andykarpov/skvosh/ERRATA-revA.txt

1. Резисторы R21, R22, R23 не запаивать либо подобрать
2. Вместо диода D8 запаять перемычку 0 Ом
3. Диоды D9, D10, D11 не запаивать
4. Питание для микросхемы К145ИК17 нужно подбирать, ориентировочно - 6В, от 5В работает нестабильно
5. В узле генератора нужно применять микросхему серии ACT, серия HC нестабильна
6. Вывечти на левый разъем пины для пистолета (возможно, вместе со схемой)
