andykarpov/skvosh/docs/skvosh-pcb-revB.pdf

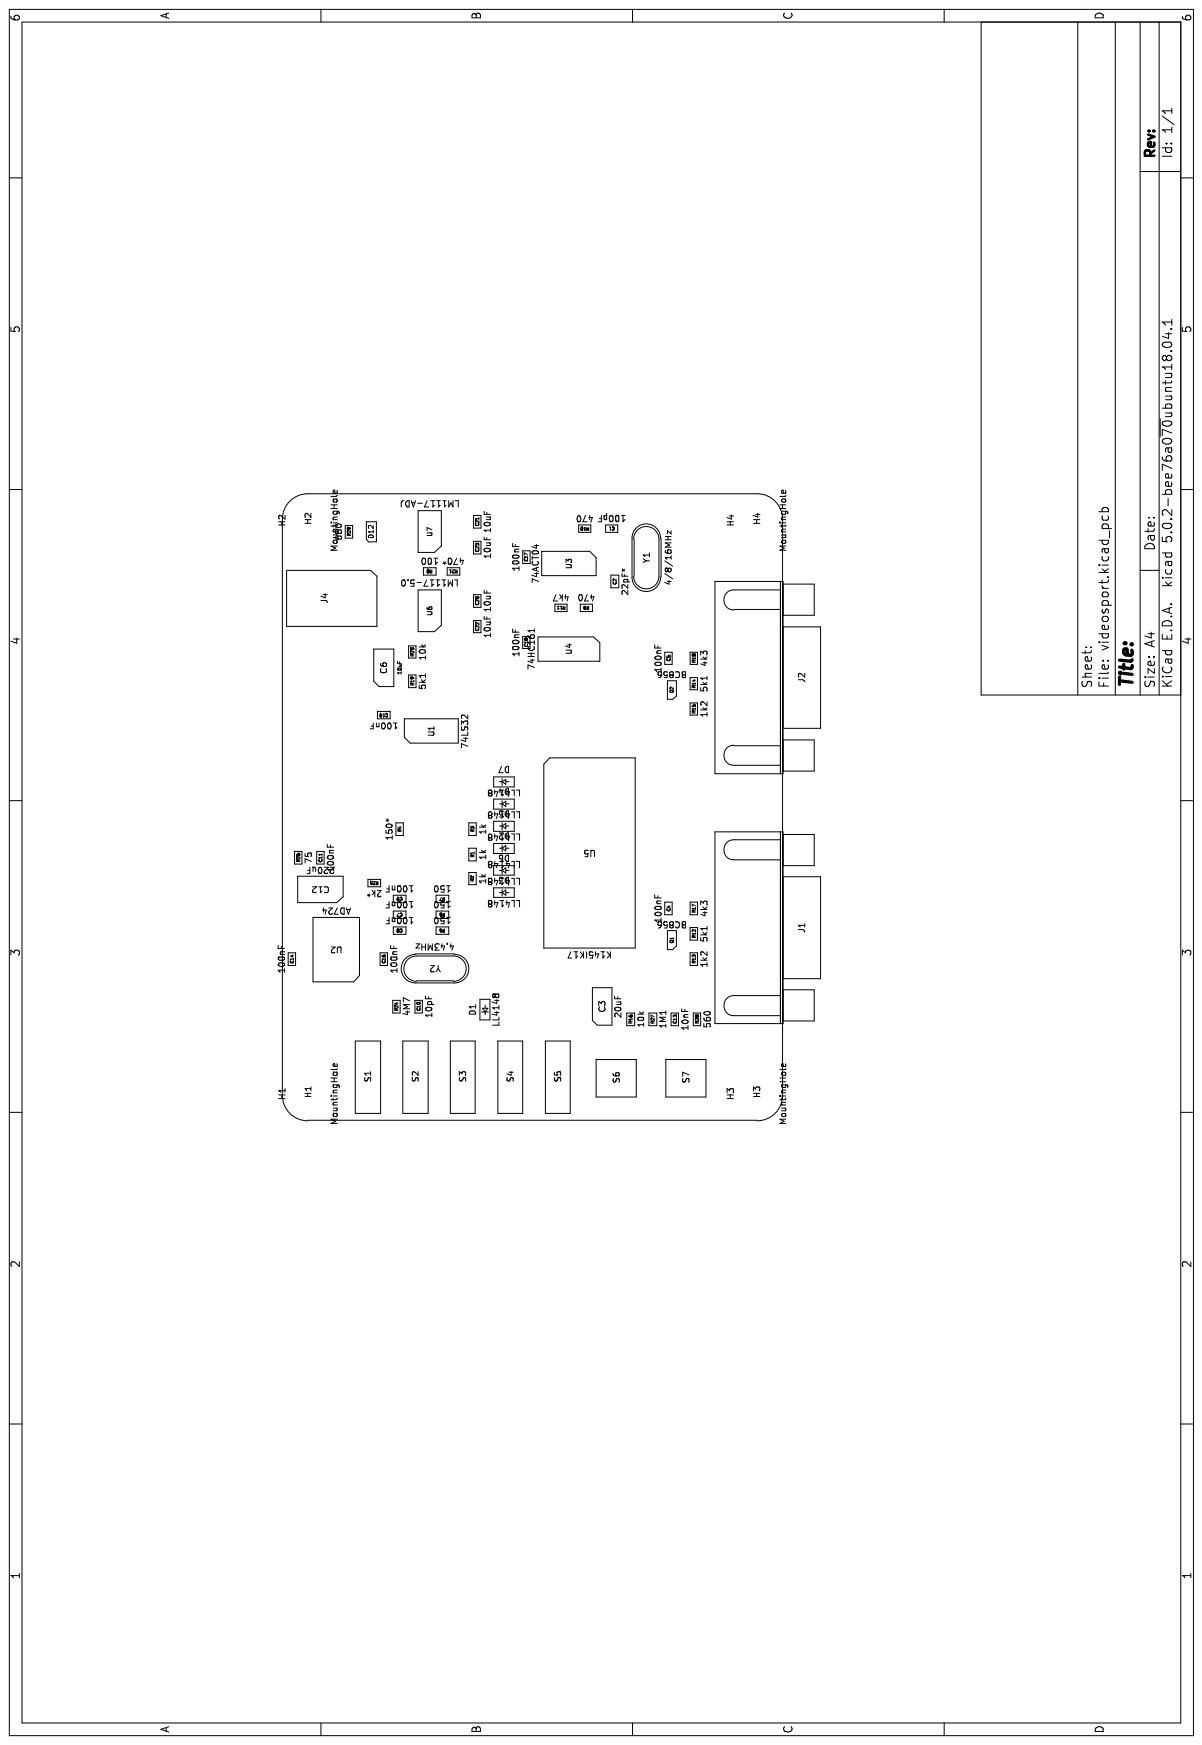
[picture p1: page 1]
