andykarpov/skvosh/docs/skvosh-sch-revB.pdf

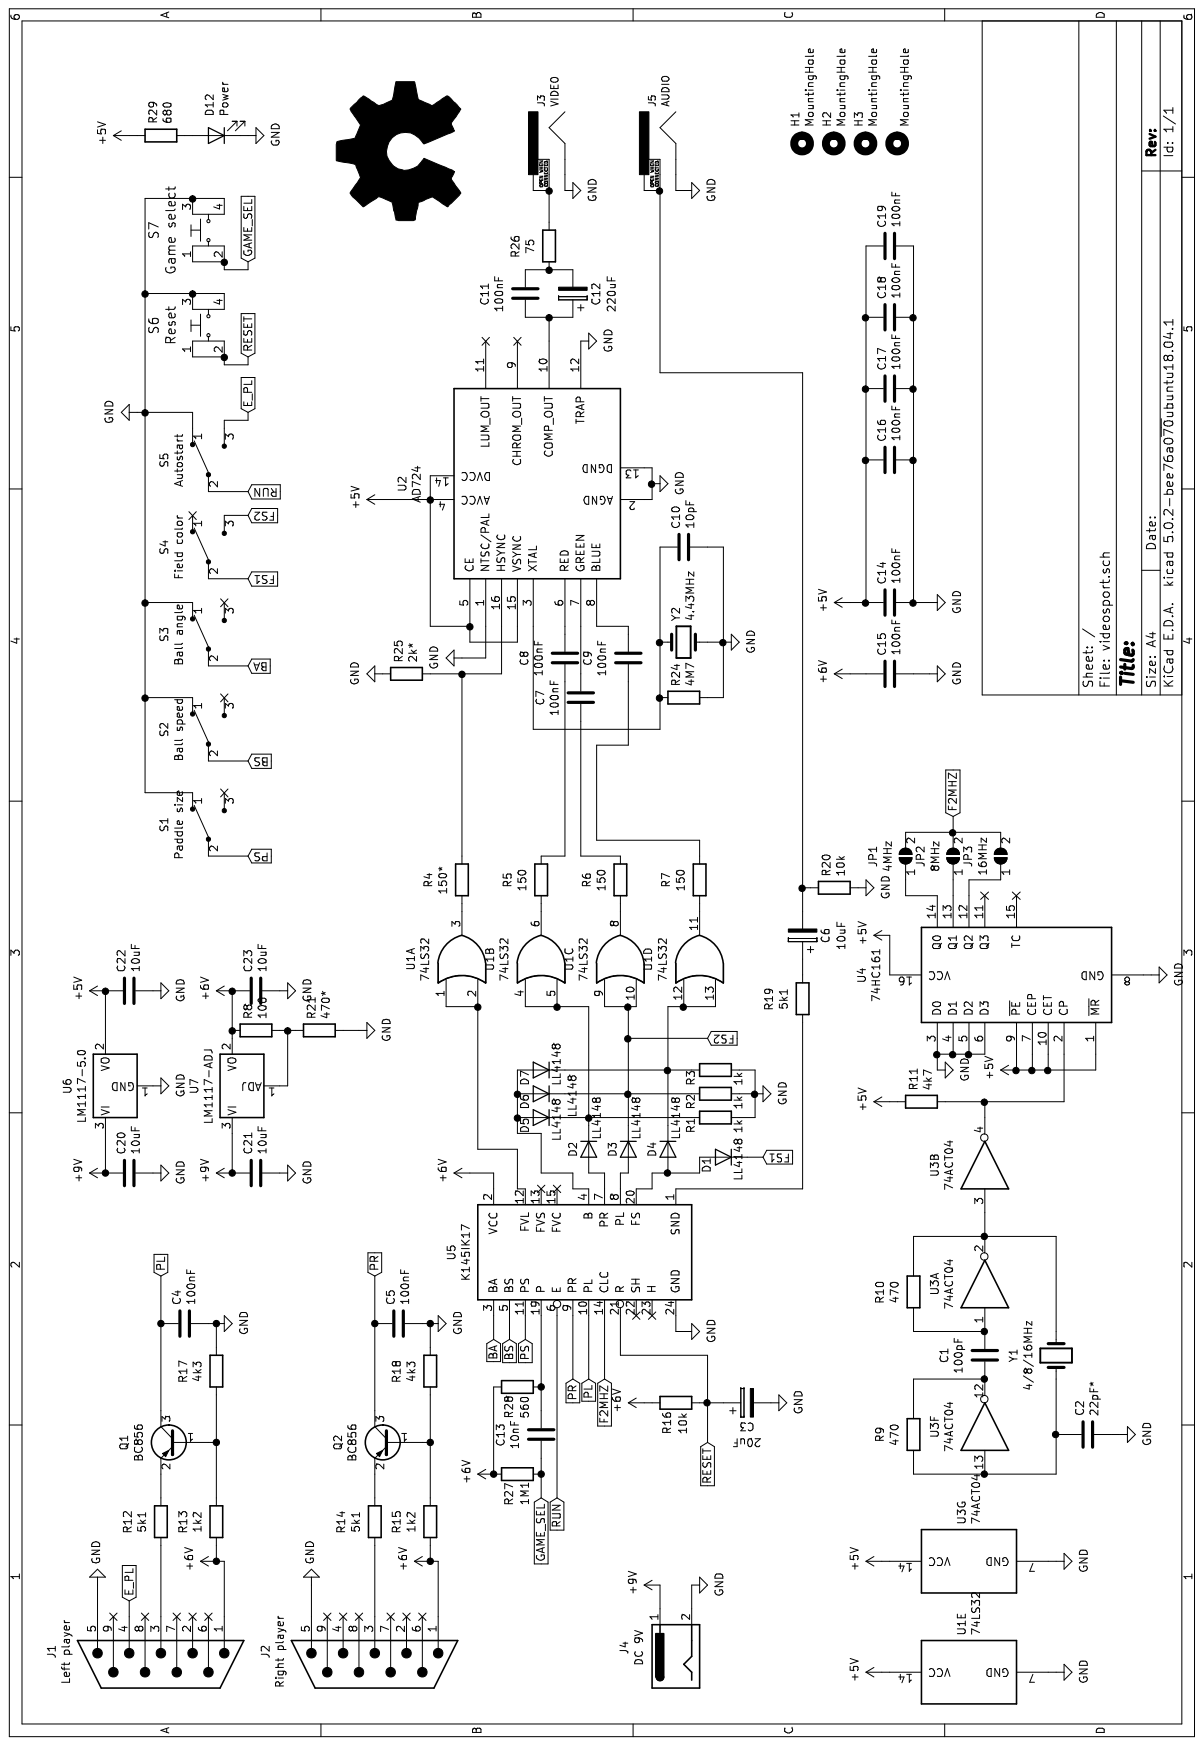
[picture p2: page 1]
