andykarpov/skvosh/docs/skvosh-pcb-revA.pdf

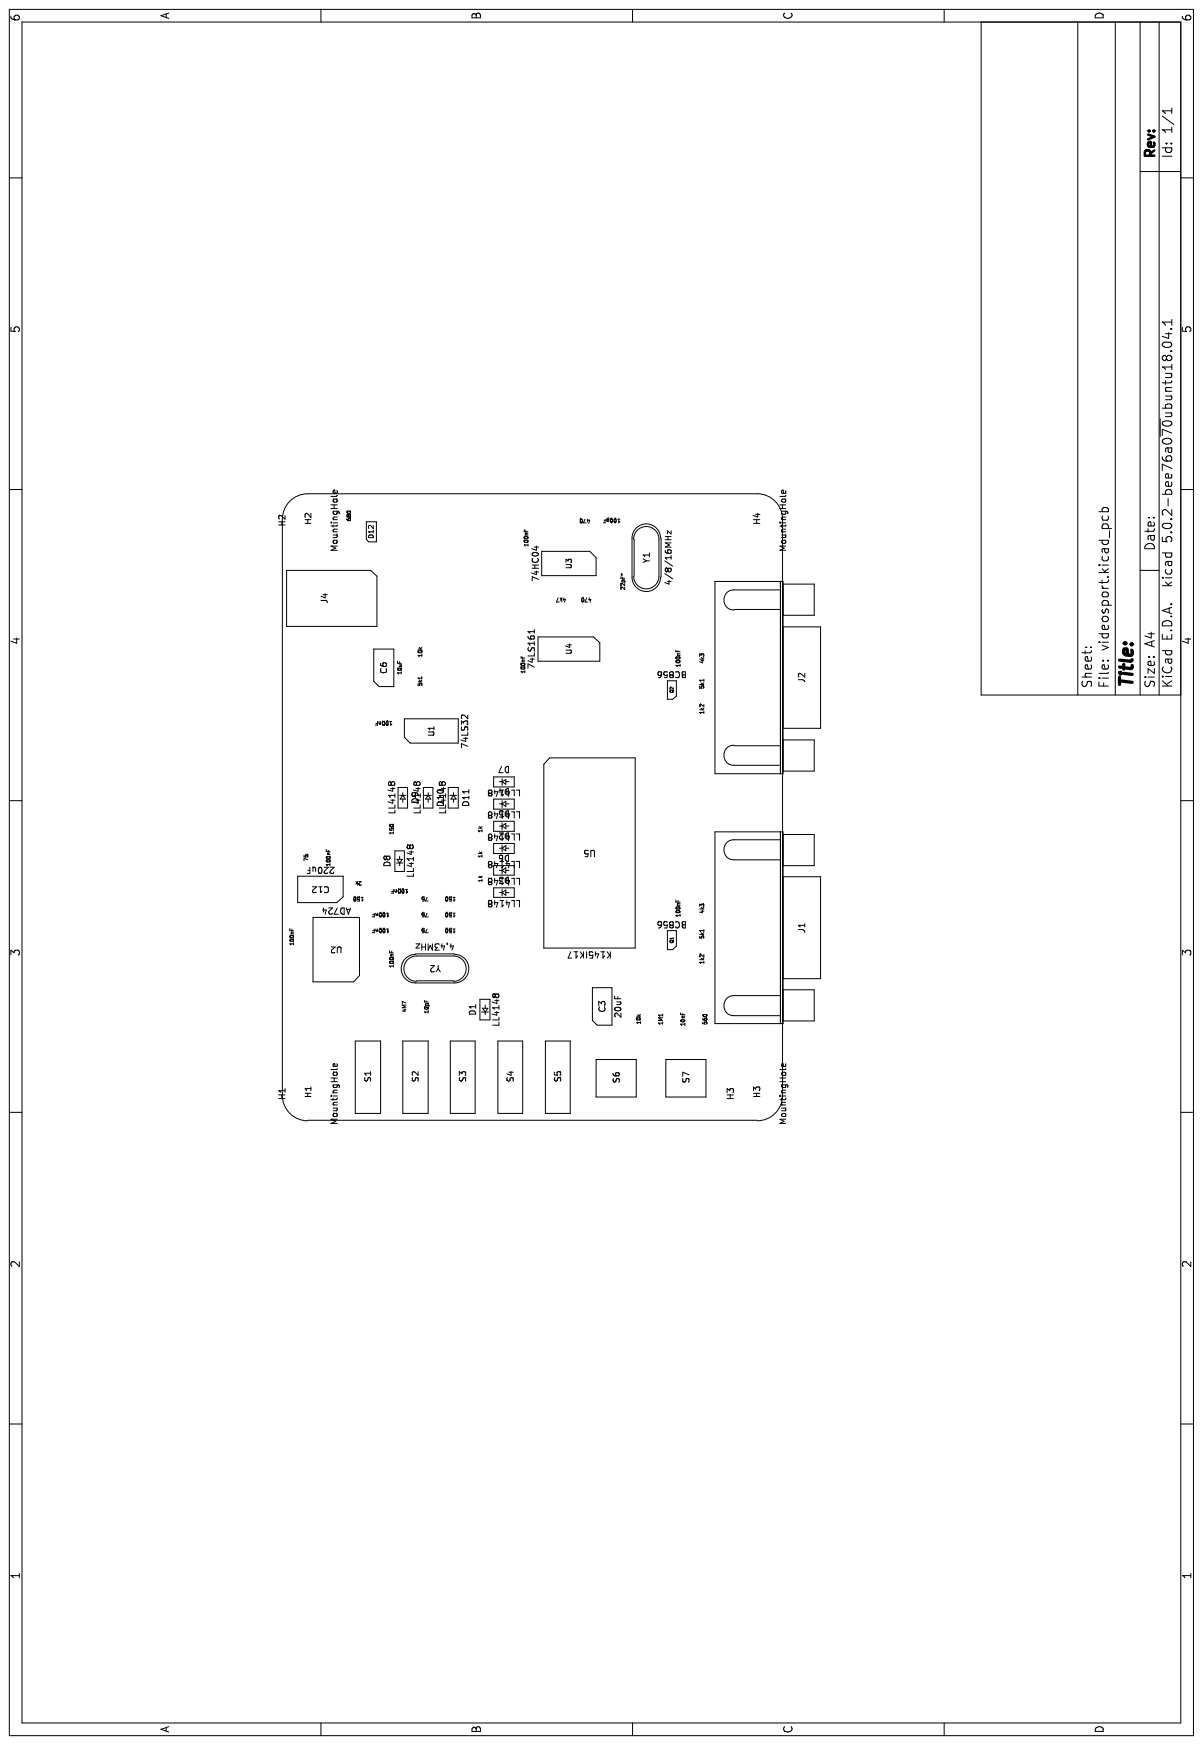
[picture p3: page 1]
