andykarpov/skvosh/docs/skvosh-sch-revA.pdf

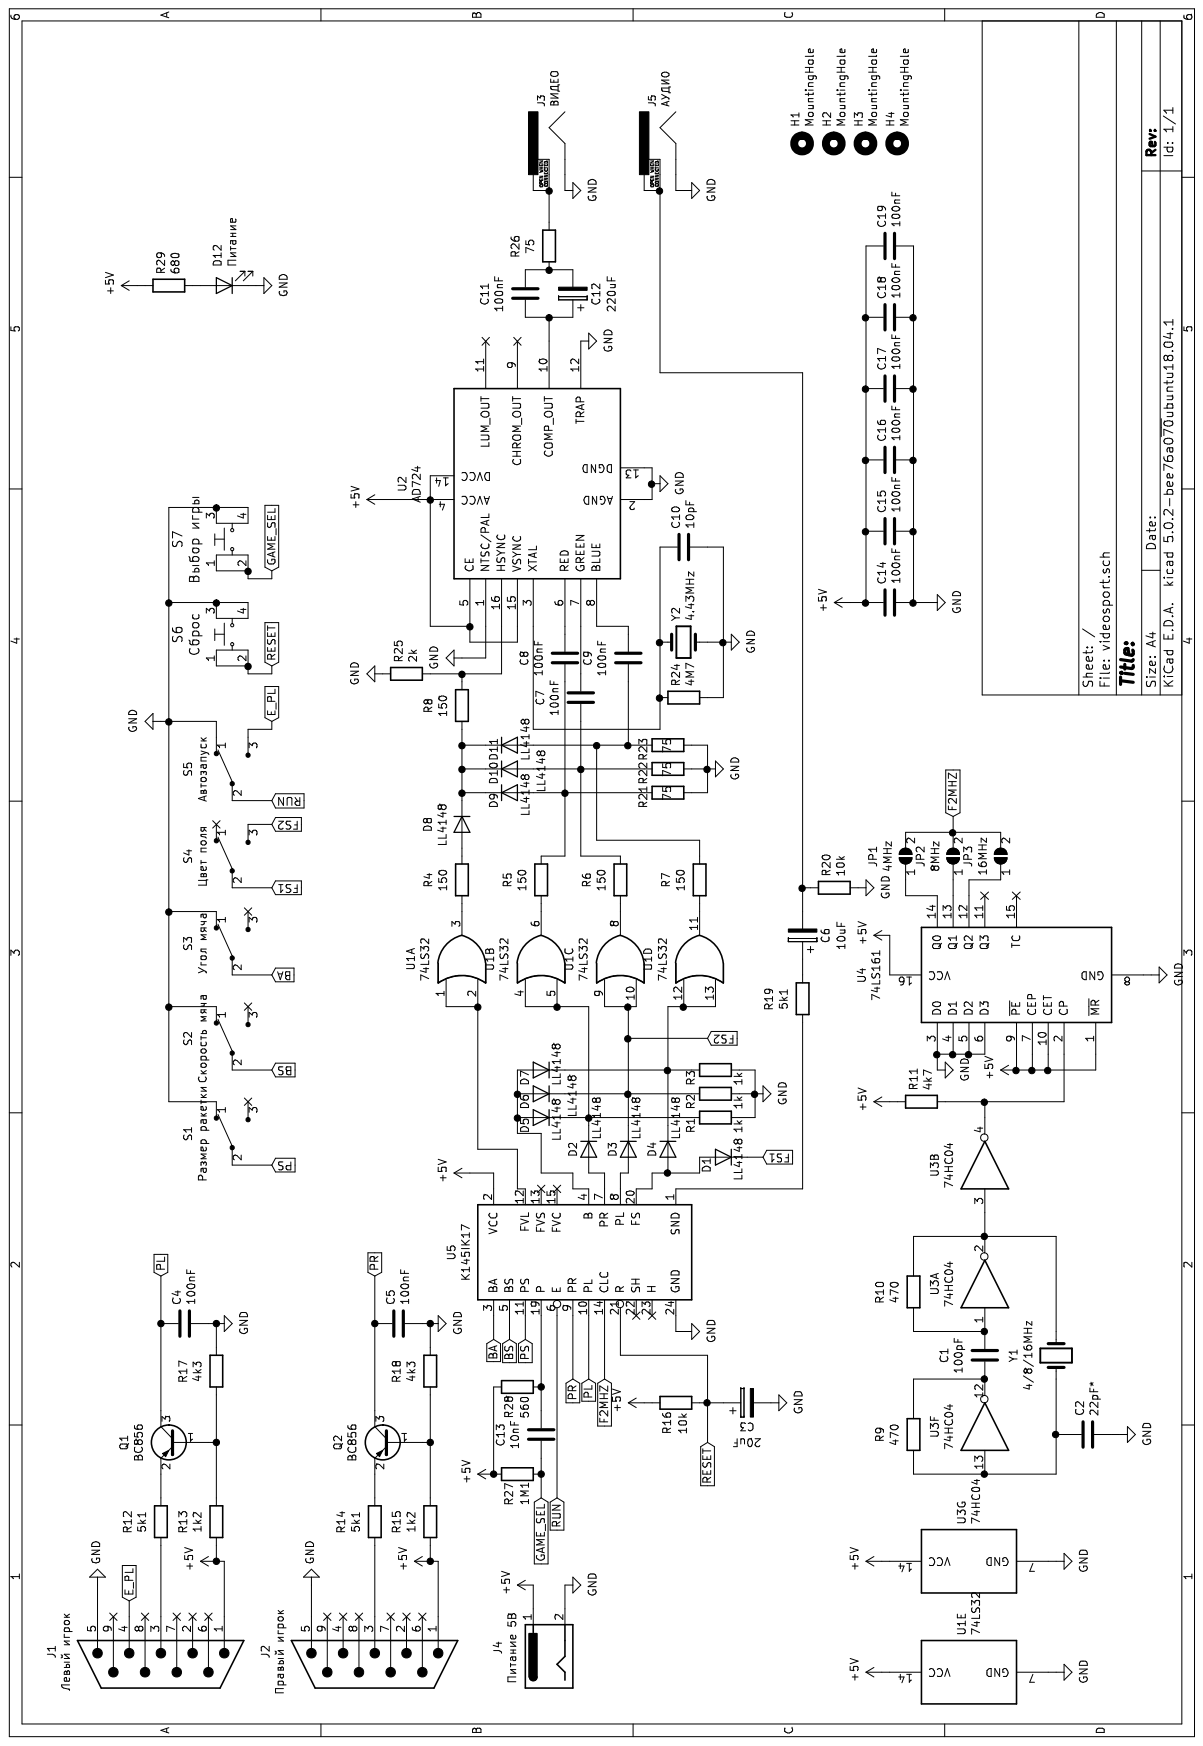
[picture p4: page 1]
