andykarpov/skvosh/pcb/revA/videosport.kicad_pcb

## KiCad design pcb/revA/videosport.kicad_pcb (2020-01-13, an earlier design)

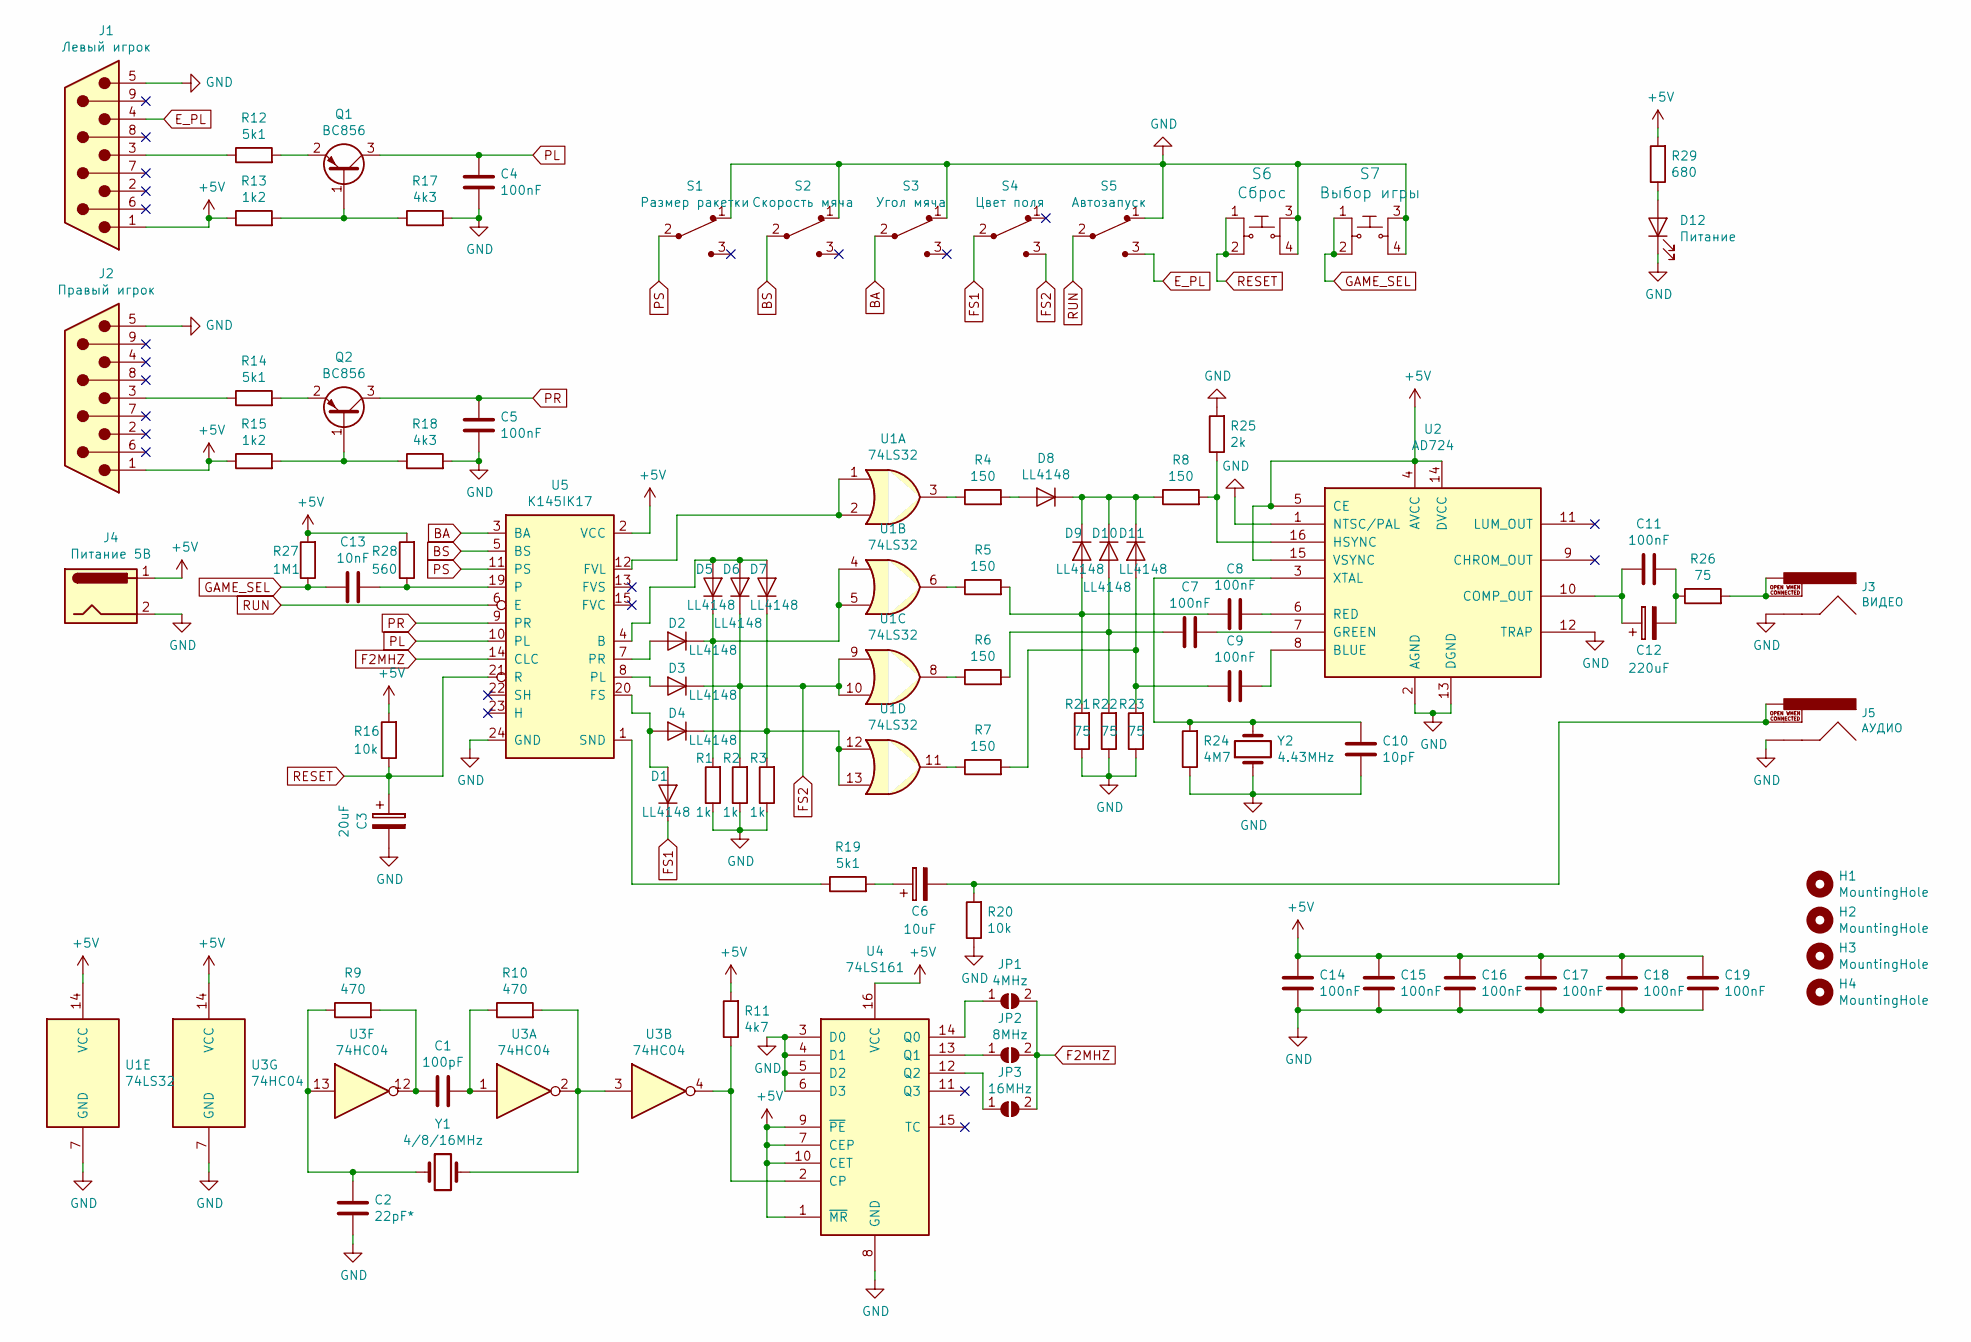
[picture p5: schematic videosport.sch]

Parts:
C1: 100pF; 0805
C2: 22pF*; 0805
C3: 20uF; CP_EIA-6032-28_Kemet-C_Pad2.25x2.35mm_HandSolder
C4, C5, C7, C8, C9, C11, C14, C15, C16, C17, C18, C19: 100nF; 0805
C6: 10uF; CP_EIA-6032-28_Kemet-C_Pad2.25x2.35mm_HandSolder
C10: 10pF; 0805
C12: 220uF; CP_EIA-7343-31_Kemet-D_Pad2.25x2.55mm_HandSolder
C13: 10nF; 0805
D1, D2, D3, D4, D5, D6, D7, D8, D9, D10, D11: LL4148; D_MiniMELF
D12: Питание; LED_1206_3216Metric_Pad1.42x1.75mm_HandSolder
H1, H2, H3, H4: MountingHole; MountingHole_3.2mm_M3_Pad_Via
J1: Левый игрок; DSUB-9_Male_Horizontal_P2.77x2.84mm_EdgePinOffset4.94mm_Hou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
J2: Правый игрок; DSUB-9_Male_Horizontal_P2.77x2.84mm_EdgePinOffset4.94mm_Hou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
J3: ВИДЕО; RCA
J4: Питание 5В; BarrelJack_Wuerth_6941xx301002
J5: АУДИО; RCA
JP1: 4MHz; SolderJumper-2_P1.3mm_Open_TrianglePad1.0x1.5mm
JP2: 8MHz; SolderJumper-2_P1.3mm_Open_TrianglePad1.0x1.5mm
JP3: 16MHz; SolderJumper-2_P1.3mm_Open_TrianglePad1.0x1.5mm
Q1, Q2: BC856; SOT-23
R1, R2, R3: 1k; 0805
R4, R5, R6, R7, R8: 150; 0805
R9, R10: 470; 0805
R11: 4k7; 0805
R12, R14, R19: 5k1; 0805
R13, R15: 1k2; 0805
R16, R20: 10k; 0805
R17, R18: 4k3; 0805
R21, R22, R23, R26: 75; 0805
R24: 4M7; 0805
R25: 2k; 0805
R27: 1M1; 0805
R28: 560; 0805
R29: 680; 0805
S1: Размер ракетки; Switch_Slide_11.6x4mm_EG1218; MPN EG1218; Digi-Key_PN EG1903-ND
S2: Скорость мяча; Switch_Slide_11.6x4mm_EG1218; MPN EG1218; Digi-Key_PN EG1903-ND
S3: Угол мяча; Switch_Slide_11.6x4mm_EG1218; MPN EG1218; Digi-Key_PN EG1903-ND
S4: Цвет поля; Switch_Slide_11.6x4mm_EG1218; MPN EG1218; Digi-Key_PN EG1903-ND
S5: Автозапуск; Switch_Slide_11.6x4mm_EG1218; MPN EG1218; Digi-Key_PN EG1903-ND
S6: Сброс; Switch_Tactile_THT_6x6mm; MPN 1825910-6; Digi-Key_PN 450-1650-ND
S7: Выбор игры; Switch_Tactile_THT_6x6mm; MPN 1825910-6; Digi-Key_PN 450-1650-ND
U1: 74LS32; SOIC-14_3.9x8.7mm_P1.27mm
U2: AD724; SOIC-16W_7.5x10.3mm_P1.27mm
U3: 74HC04; SOIC-14_3.9x8.7mm_P1.27mm
U4: 74LS161; SOIC-16_3.9x9.9mm_P1.27mm
U5: K145IK17; DIP-24_W15.24mm
Y1: 4/8/16MHz; Crystal_HC49-U_Vertical
Y2: 4.43MHz; Crystal_HC49-U_Vertical

Connections:
+5V: C14.2, C15.2, C16.2, C17.2, C18.2, C19.2, J1.1, J2.1, J4.1, R11.2, R13.1, R15.1, R16.2, R27.2, R28.2, R29.2, U1.14 (VCC), U2.4 (AVCC), U2.5 (CE), U2.14 (DVCC), U2.15 (VSYNC), U3.14 (VCC), U4.1 (~MR), U4.7 (CEP), U4.9 (~PE), U4.10 (CET), U4.16 (VCC), U5.2 (VCC)
BA: S3.2, U5.3 (BA)
BS: S2.2, U5.5 (BS)
E_PL: J1.4, S5.3
F2MHZ: JP1.2 (B), JP2.2 (B), JP3.2 (B), U5.14 (CLC)
FS1: D1.1 (K), S4.2
FS2: D3.1 (K), D6.1 (K), R2.2, S4.3, U1.9, U1.10
GAME_SEL: C13.1, R27.1, S7.1, S7.2
GND: C2.1, C3.2, C4.1, C5.1, C10.1, C14.1, C15.1, C16.1, C17.1, C18.1, C19.1, D12.1 (K), J1.5, J2.5, J3.SHEL (SHELL), J4.2, J5.SHEL (SHELL), R1.1, R2.1, R3.1, R17.2, R18.2, R20.1, R21.1, R22.1, R23.1, R24.1, R25.2, S1.1, S2.1, S3.1, S5.1, S6.3, S6.4, S7.3, S7.4, U1.7 (GND), U2.1 (NTSC/PAL), U2.2 (AGND), U2.12 (TRAP), U2.13 (DGND), U3.7 (GND), U4.3 (D0), U4.4 (D1), U4.5 (D2), U4.6 (D3), U4.8 (GND), U5.24 (GND), Y2.1
unnamed: C1.1, R9.2, U3.12
unnamed: C1.2, R10.1, U3.1
unnamed: C2.2, R9.1, U3.13, Y1.1
unnamed: C6.1, R19.2
unnamed: C6.2, J5.PIN, J5.SWIT (SWITCH), R20.2
unnamed: C7.1, D10.2 (A), R6.2, R22.2
unnamed: C7.2, U2.7 (GREEN)
unnamed: C8.1, D9.2 (A), R5.2, R21.2
unnamed: C8.2, U2.6 (RED)
unnamed: C9.1, D11.2 (A), R7.2, R23.2
unnamed: C9.2, U2.8 (BLUE)
unnamed: C10.2, R24.2, U2.3 (XTAL), Y2.2
unnamed: C11.1, C12.1, U2.10 (COMP_OUT)
unnamed: C11.2, C12.2, R26.1
unnamed: C13.2, R28.1, U5.19
unnamed: D1.2 (A), D4.2 (A), U5.20 (FS)
unnamed: D2.1 (K), D5.1 (K), R1.2, U1.4, U1.5
unnamed: D2.2 (A), U5.7 (PR)
unnamed: D3.2 (A), U5.8 (PL)
unnamed: D4.1 (K), D7.1 (K), R3.2, U1.12, U1.13
unnamed: D5.2 (A), D6.2 (A), D7.2 (A), U5.4 (B)
unnamed: D8.2 (A), R4.2
unnamed: D8.1 (K), D9.1 (K), D10.1 (K), D11.1 (K), R8.1
unnamed: D12.2 (A), R29.1
unnamed: J1.3, R12.1
unnamed: J2.3, R14.1
unnamed: J3.PIN, J3.SWIT (SWITCH), R26.2
unnamed: JP1.1 (A), U4.14 (Q0)
unnamed: JP2.1 (A), U4.13 (Q1)
unnamed: JP3.1 (A), U4.12 (Q2)
unnamed: Q1.1 (B), R13.2, R17.1
unnamed: Q1.2 (E), R12.2
unnamed: Q2.1 (B), R15.2, R18.1
unnamed: Q2.2 (E), R14.2
unnamed: R4.1, U1.3
unnamed: R5.1, U1.6
unnamed: R6.1, U1.8
unnamed: R7.1, U1.11
unnamed: R10.2, U3.2, U3.3, Y1.2
unnamed: R11.1, U3.4, U4.2 (CP)
unnamed: R19.1, U5.1 (SND)
unnamed: R8.2, R25.1, U2.16 (HSYNC)
unnamed: U1.1, U1.2, U5.12 (FVL)
PL: C4.2, Q1.3 (C), U5.10 (PL)
PR: C5.2, Q2.3 (C), U5.9 (PR)
PS: S1.2, U5.11 (PS)
RESET: C3.1, R16.1, S6.1, S6.2, U5.21 (R)
RUN: S5.2, U5.6 (E)

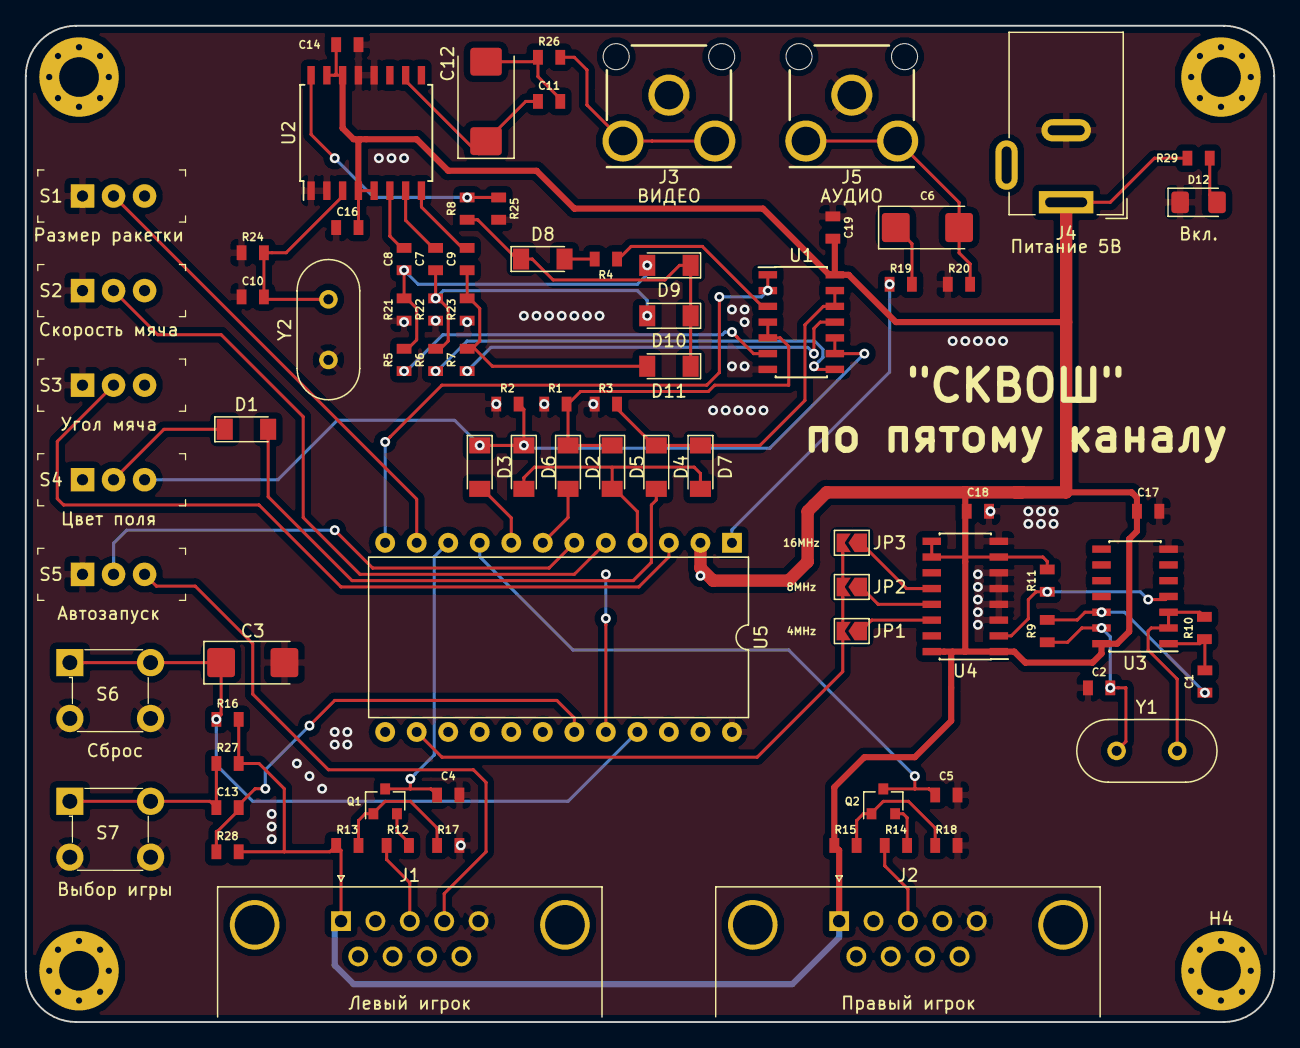
[picture p6: board videosport.kicad_pcb from above]

Board: 2 copper layers, 100.6 x 80.3 mm, 88 parts (1 on the bottom side), 57 nets.
